Peugh18/Memora/README.md

# Memora

Pastillero inteligente 7 × 4 (ESP32) + API Laravel + app Android (Expo). Proyecto universitario, Trujillo, Perú.

- `firmware/` pastillero ESP32 · `servidor/` API · `app/` app móvil · `despliegue/` AWS · `diseno/` pantallas aprobadas
- Empieza por [AGENTS.md](AGENTS.md) y [docs/ai/PROYECTO.md](docs/ai/PROYECTO.md).
