Peugh18/Memora/caja/memora-caja-corte.pdf

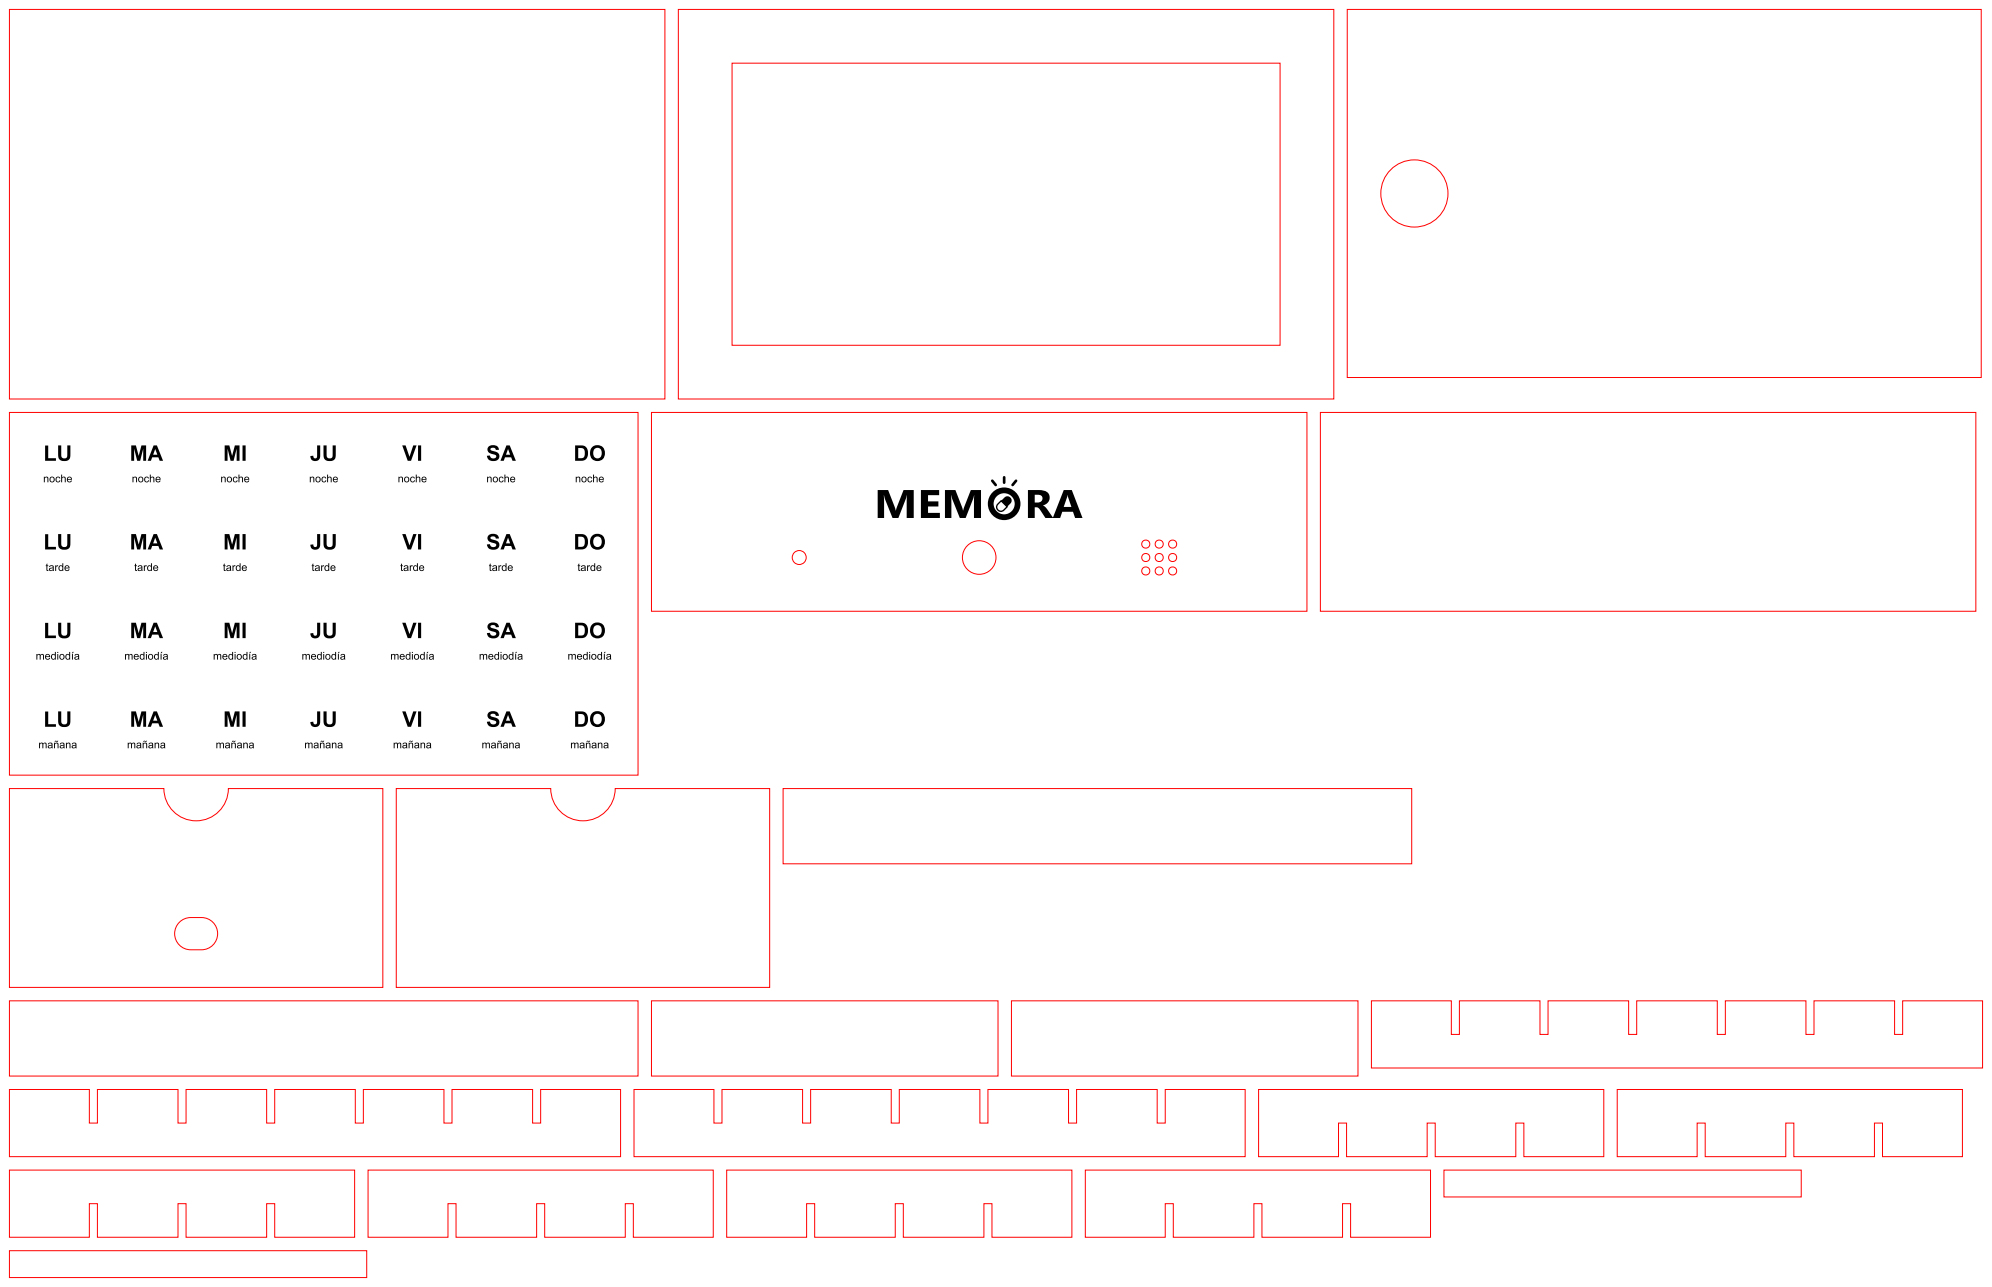
[picture p1: page 1]
