Peugh18/Memora/caja/memora-caja-guia.png

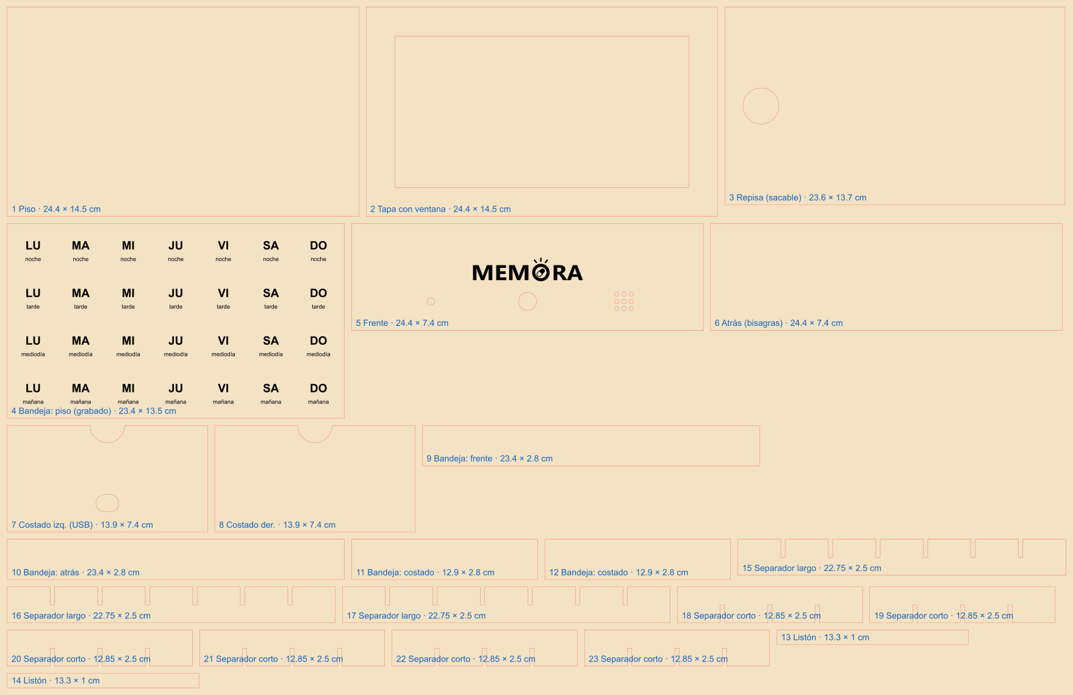
caja/memora-caja-guia.png
