Peugh18/Memora/caja/memora-caja-corte.dxf

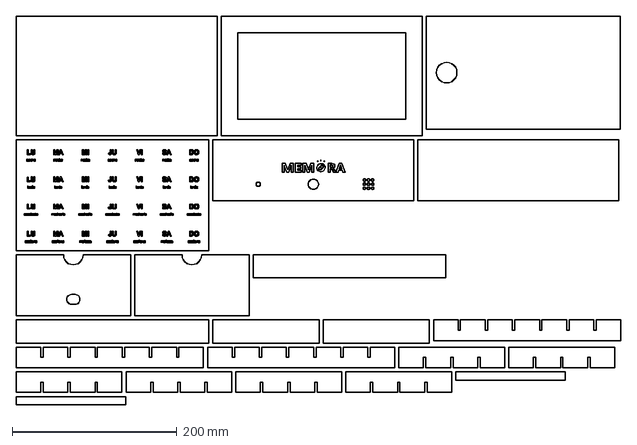
[picture p3: CAD file, 2026-10-25]
caja/memora-caja-corte.dxf
734.5 x 472.0 mm
