Peugh18/Memora/docs/manual/Manual-de-usuario-Memora.pdf

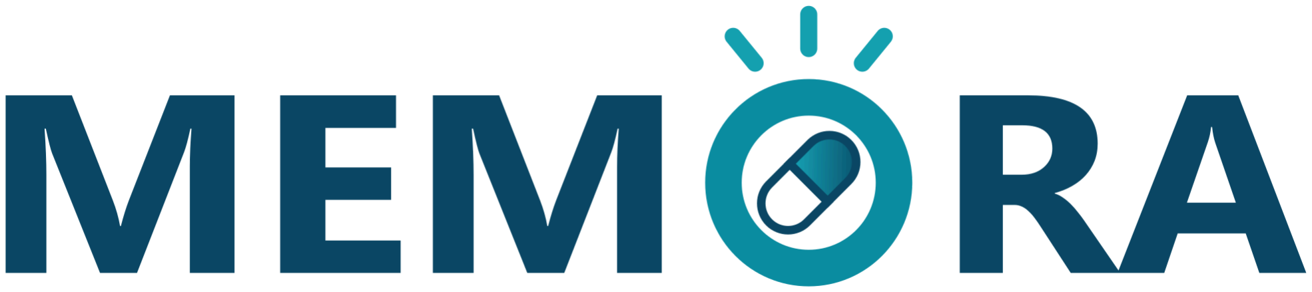
[picture p27: figure]

# Manual de usuario

### App Memora y pastillero inteligente

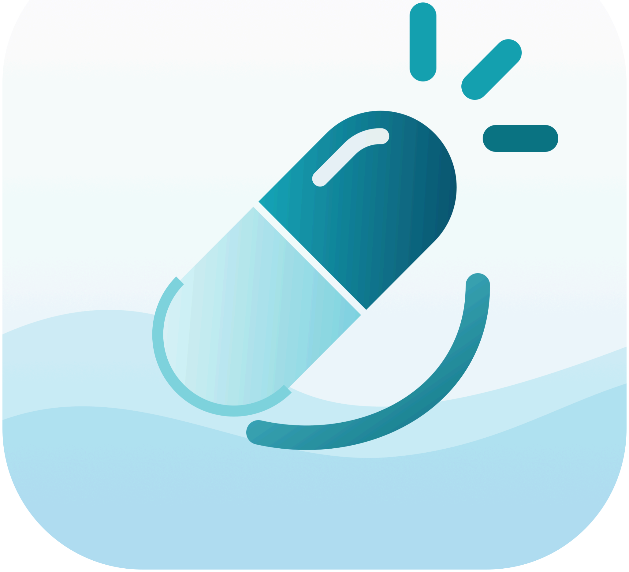
[picture p28: figure]

Versión 1.1 · octubre de 2026

## Contenido

1. Qué es Memora
2. Instalar la app
3. Conoce tu pastillero
4. Crear tu cuenta
5. Conectar el pastillero
6. Tu día: la pantalla Hoy
7. Pastillero y horarios
8. Medicamentos
9. Historial
10. Mi familia
11. Perfil y ajustes
12. Si cuidas a alguien
13. Volver a entrar
14. Si algo no funciona

## 1 Qué es Memora

Memora tiene dos partes que trabajan juntas:
El pastillero: una caja de 7 días por 4 tomas (mañana, mediodía, tarde y noche). A la hora de cada toma suena y prende su luz verde. Cuando tomas la pastilla, presionas su botón.
La app Memora en tu celular: ahí armas tu rutina, ves qué toca hoy y confirmas tus tomas. Tu familia también puede instalarla para acompañarte.
Si pasan 30 minutos y la toma no se confirma, Memora les avisa a las personas que te cuidan.

Lo que necesitas
Un celular Android con internet.
El pastillero enchufado a un cargador de celular (5 V).
Una red Wi-Fi de 2,4 GHz para el pastillero. Las redes de 5 GHz no funcionan. El código QR que viene pegado dentro de la tapa del pastillero.

## 2 Instalar la app

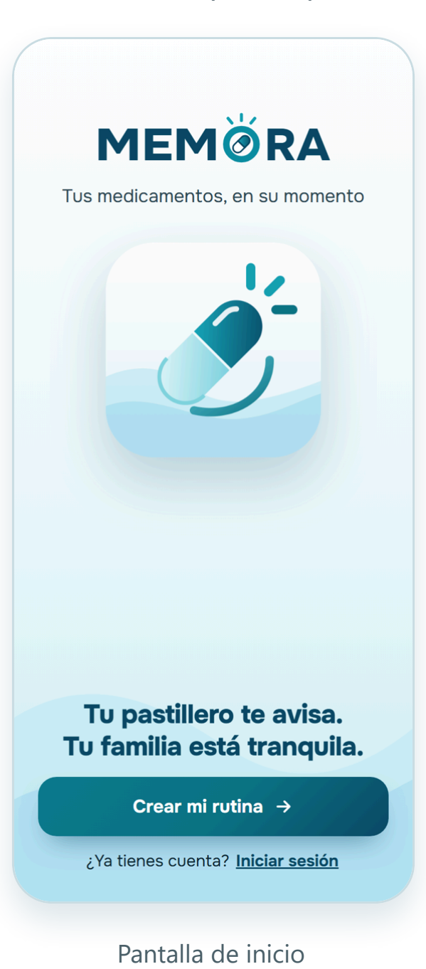
[picture p29: figure]
Pantalla de inicio

1. Abre en tu celular el enlace de descarga del archivo Memora.apk.
2. Toca Descargar y, al terminar, abre el archivo.

3. Si Android pide permiso para instalar apps de fuentes desconocidas, actívalo solo para tu navegador o tu gestor de archivos.
4. Toca Instalar. El ícono de Memora aparece en tu pantalla de inicio.

La primera vez que abras Memora, el celular te preguntará si permites notificaciones. Toca Permitir: así te llega el recordatorio a la hora de cada toma y, si cuidas a alguien, el aviso cuando no confirma.

## 3 Conoce tu pastillero

Lo que ves u oyes | Qué significa
Luz verde fija | Está conectado a internet y a Memora.
Luz verde apagada | Está sin internet. Igual suena a sus horas.
Bip-bip y luz que parpadea | Es hora de una toma.
Botón | Presiónalo cuando suene: apaga la alarma y avisa en la app que ya tomaste.
Botón presionado 10 segundos (sin alarma) | Borra el Wi-Fi guardado, para conectarlo a otra red.

Las 4 filas de colores son las 4 tomas del día: mañana (amarilla), mediodía (celeste), tarde (lila) y noche (rosa). Cada columna es un día, de lunes a domingo.
El pastillero guarda tu horario y la hora, así que suena aunque se vaya el internet.

## 4 Crear tu cuenta

1. En la pantalla de inicio toca Crear mi rutina.
2. Escribe tus nombres, tus apellidos y cómo quieres que te llamemos. Ese nombre corto es el que verás en el saludo.
3. Escribe tu celular. Marca Este número tiene WhatsApp si lo usas, para que tu familia pueda escribirte con un toque.
4. Elige cómo usarás Memora: Tomo medicamentos, Cuido a alguien o Las dos cosas.

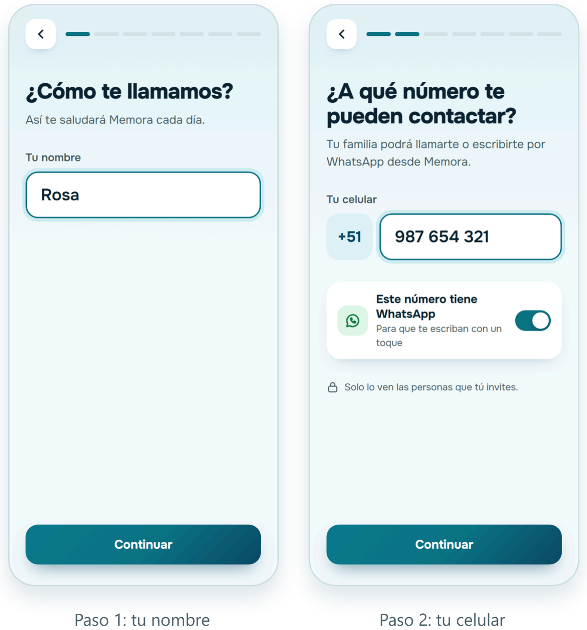
[picture p30: figure]
Paso 1: tu nombre; Paso 2: tu celular

1. Pon la hora de cada toma. Son las 4 filas de colores de tu pastillero; puedes cambiarlas después.
2. Agrega tu primer medicamento: nombre, dosis y en qué momentos del día lo tomas. Si prefieres, toca Lo agrego después.
3. Escribe tu correo y una contraseña de al menos 8 caracteres, y toca Crear cuenta.

Si solo cuidas a alguien, la app no te pide horarios ni medicamentos. Después de crear la cuenta te pide el código de invitación (sección 12).

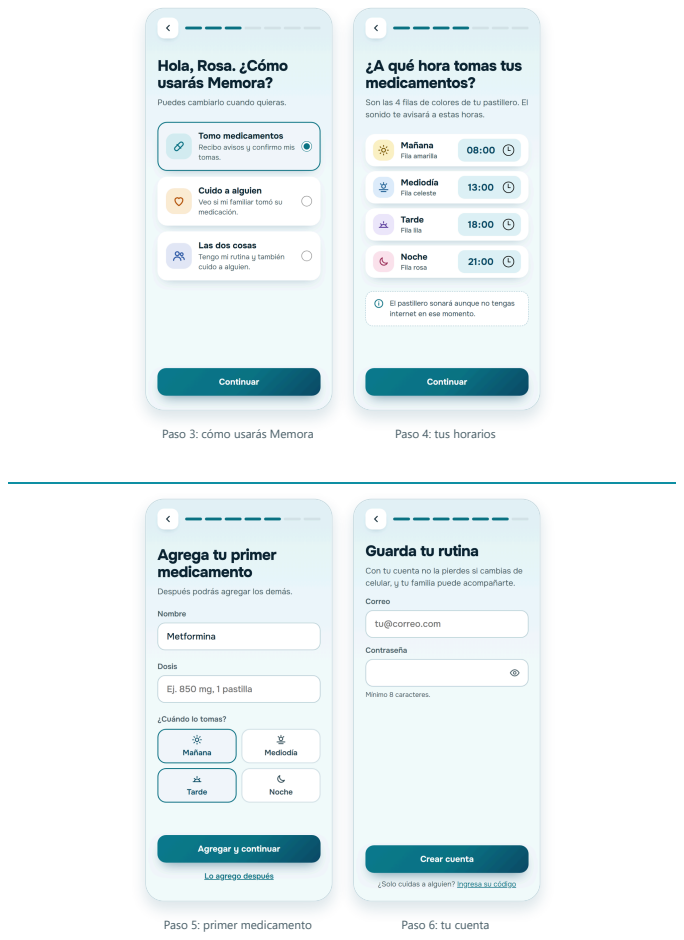
[picture p31: page 6]
Paso 3: cómo usarás Memora; Paso 4: tus horarios; Paso 5: primer medicamento; Paso 6: tu cuenta

## 5 Conectar el pastillero

Vincúlalo a tu cuenta
1. En la pantalla Conecta tu pastillero, apunta la cámara al QR pegado dentro de la tapa.
2. Si la cámara no lo lee, toca Escribir el código a mano y copia el código que está debajo del QR, por ejemplo MEM-0001-XXXXXX.
Dale tu Wi-Fi (solo la primera vez)
1. Enchufa el pastillero. Si no conoce ninguna red, crea la suya: Memora-MEM-0001.
2. En los ajustes de Wi-Fi de tu celular, conéctate a Memora-MEM-0001. Se abre una página; si no, entra a 192.168.4.1 en el navegador.
3. Toca Configure WiFi, elige tu red de 2,4 GHz, escribe su clave y guarda.
4. Cuando la luz verde quede fija, ya está listo. Vuelve tu celular a tu Wi-Fi de siempre.

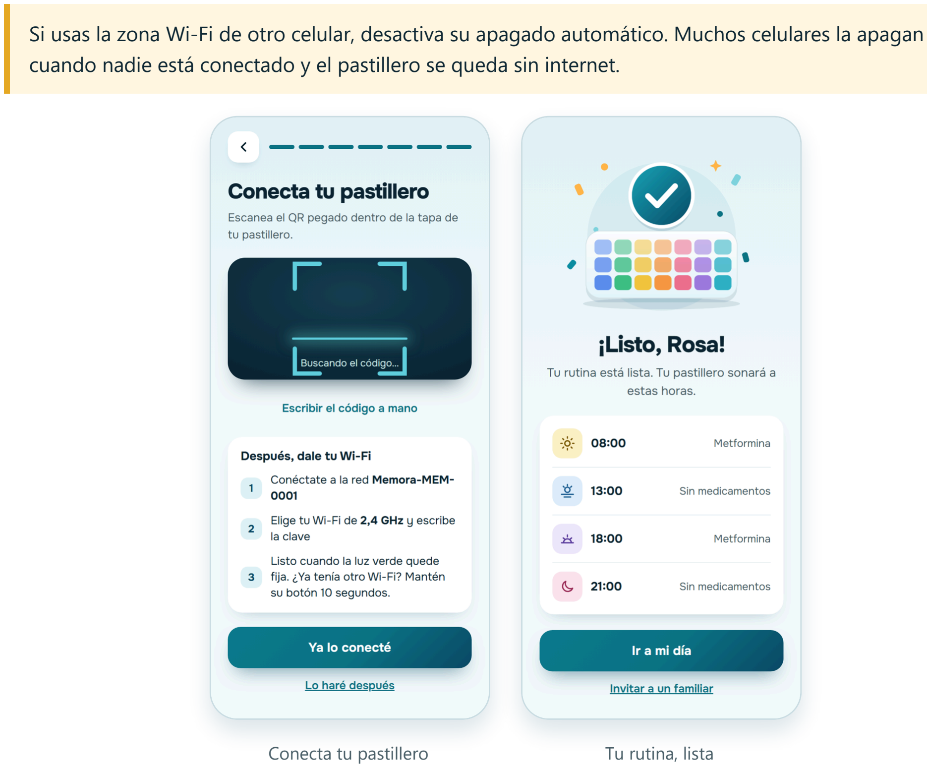
[picture p32: figure]
Conecta tu pastillero; Tu rutina, lista

Si usas la zona Wi-Fi de otro celular, desactiva su apagado automático. Muchos celulares la apagan cuando nadie está conectado y el pastillero se queda sin internet.

## 6 Tu día: la pantalla Hoy

Es la pantalla principal. Arriba ves la toma que toca y qué compartimento abrir. En la esquina, En línea indica que el pastillero está conectado.
Cuando el pastillero suena tienes tres opciones:
Presionar el botón del pastillero. Se calla y la app marca la toma como tomada en pocos segundos.
Ya la tomé, en la app: apaga el sonido y marca la toma.
Solo apagar el sonido: se calla, pero la toma sigue pendiente. Confírmala cuando la tomes. Si pasan 30 minutos, tu familia recibe un aviso.
A la misma hora te llega una notificación al celular, por ejemplo Hora de tus pastillas de la tarde. Llega aunque la app esté cerrada.
Si te equivocaste, toca Deshacer y la toma vuelve a quedar pendiente.
Abajo está la lista del día: Tomada con su hora, Ahora, Pendiente o Libre (sin medicamentos en ese momento).

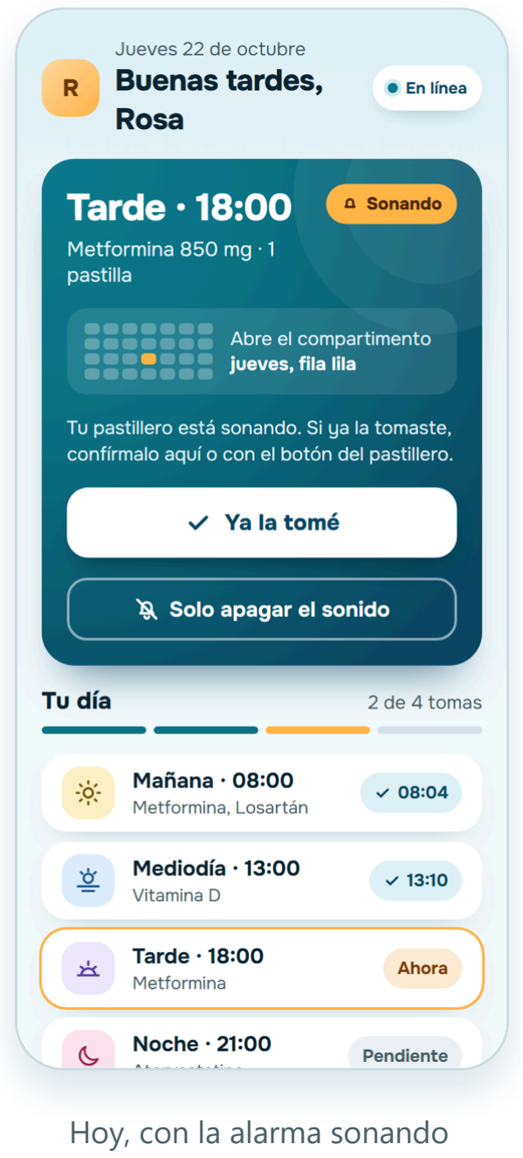
[picture p33: figure]
Hoy, con la alarma sonando

## 7 Pastillero y horarios

Toca la pestaña Pastillero.
La cuadrícula es igual a tu pastillero: el número dice cuántos medicamentos van en cada compartimento. La columna de hoy está resaltada.
Probar sonido hace sonar el pastillero; vuelve a tocar el botón, que ahora dice Apagar, para callarlo.
Para cambiar una hora, toca − o + (en pasos de 15 minutos) y luego Guardar horarios. El pastillero recibe la hora nueva en segundos.

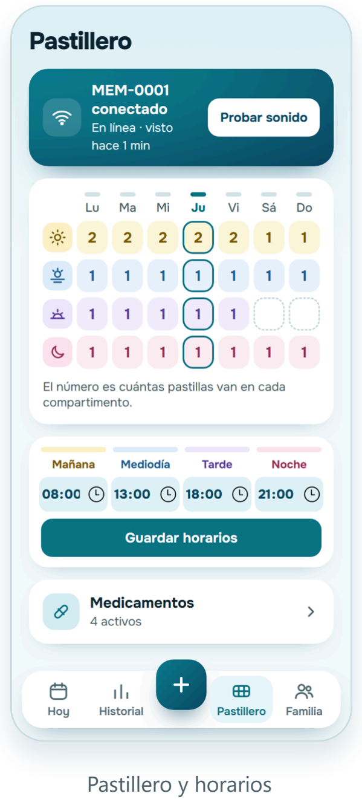
[picture p34: figure]
Pastillero y horarios

## 8 Medicamentos

1. Desde Pastillero toca Medicamentos, o toca el botón + de la barra de abajo.
2. Para uno nuevo: escribe nombre y dosis, elige los momentos del día y los días de la semana, y toca Guardar medicamento.
3. Para cambiar uno, tócalo en la lista. Para quitarlo, entra y toca Quitar medicamento.
Cada cambio actualiza solo el horario del pastillero: solo suena en los momentos que tienen medicamento.

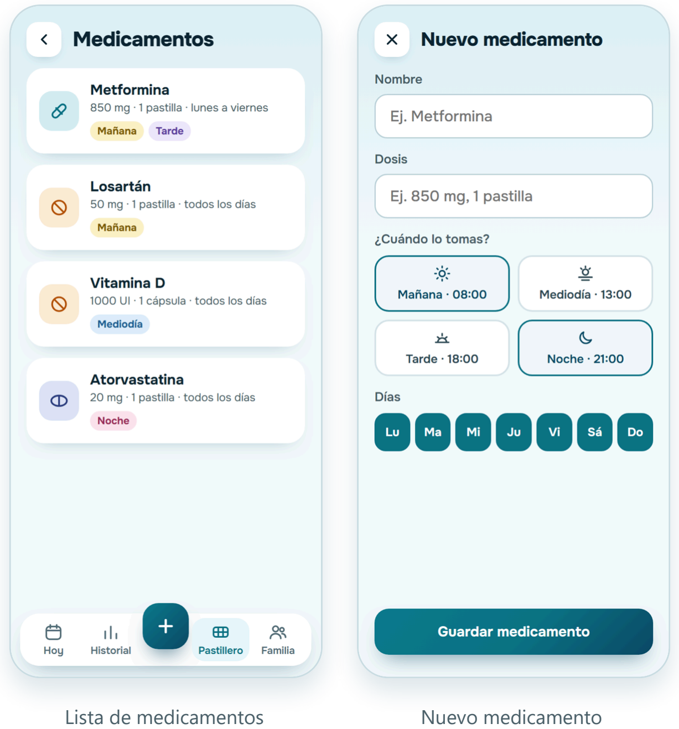
[picture p35: figure]
Lista de medicamentos; Nuevo medicamento

## 9 Historial

La pestaña Historial muestra tu semana: cada barra es un día, en turquesa las tomas confirmadas y en naranja las que no se confirmaron.
Debajo ves el porcentaje de tomas confirmadas de las últimas 4 semanas y la lista de tomas sin confirmar de esta semana.

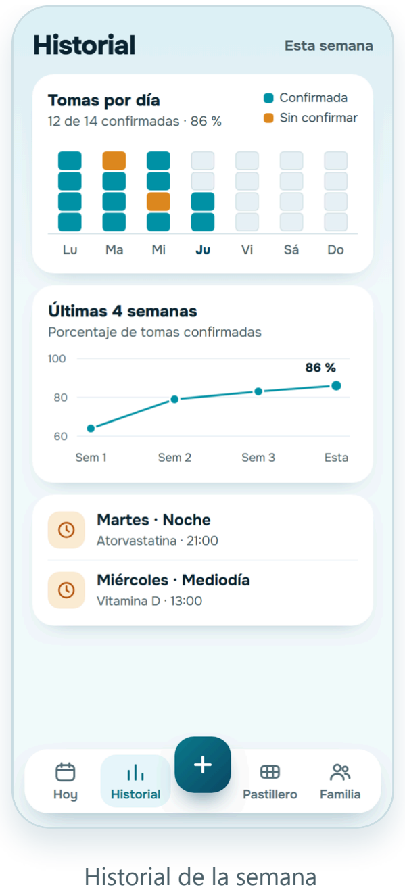
[picture p36: figure]
Historial de la semana

## 10 Mi familia

1. Toca la pestaña Familia.
2. En Invita a un familiar aparece tu código (vence en 24 horas). Cópialo o toca Compartir por WhatsApp.
3. Tu familiar lo escribe en su app (sección 12) y aparece en tu lista.
Junto a cada familiar tienes botones para llamarlo o escribirle por WhatsApp. El interruptor Puede editar mis horarios le da permiso para cambiar tus horas y medicamentos. Las tomas solo las confirmas tú.

## 11 Perfil y ajustes

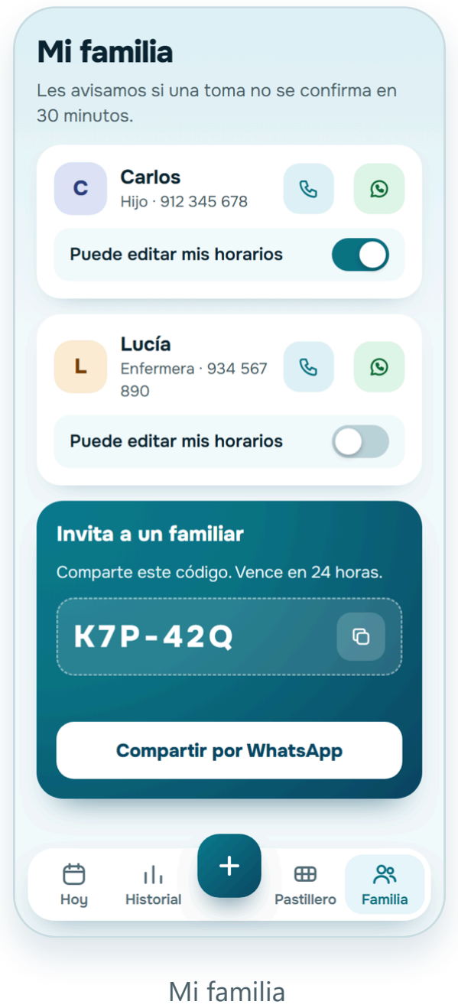
[picture p37: figure]
Mi familia

Toca tu inicial, arriba a la izquierda en Hoy.
Datos personales: nombre, cómo te llamamos, celular, correo y contraseña.
Avisar a mi familia tras: tócalo para elegir 15, 30, 45 o 60 minutos.
Avisos en el celular: el recordatorio a la hora de cada toma y, si cuidas a alguien, el aviso cuando no confirma. Avisos por WhatsApp: actívalo si prefieres ese medio.
Cambiar el Wi-Fi del pastillero: repite los pasos de la sección 5.

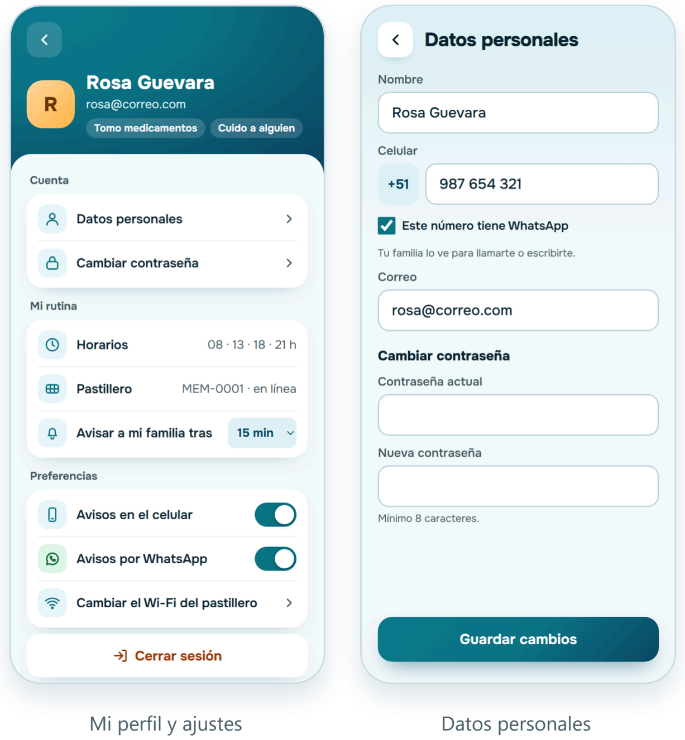
[picture p38: figure]
Mi perfil y ajustes; Datos personales

Cerrar sesión, al final de la pantalla.

## 12 Si cuidas a alguien

1. Crea tu cuenta eligiendo Cuido a alguien.
2. Escribe el código de invitación que te pasó tu familiar, elige qué es de ti (mamá, papá, etc.) y toca Unirme.
3. En Personas que cuido ves a cada persona con sus tomas de hoy. Si alguien no confirmó a tiempo, aparece un aviso naranja arriba.
4. Toca a la persona para ver su semana, llamarla o escribirle por WhatsApp. Si te dio permiso, verás

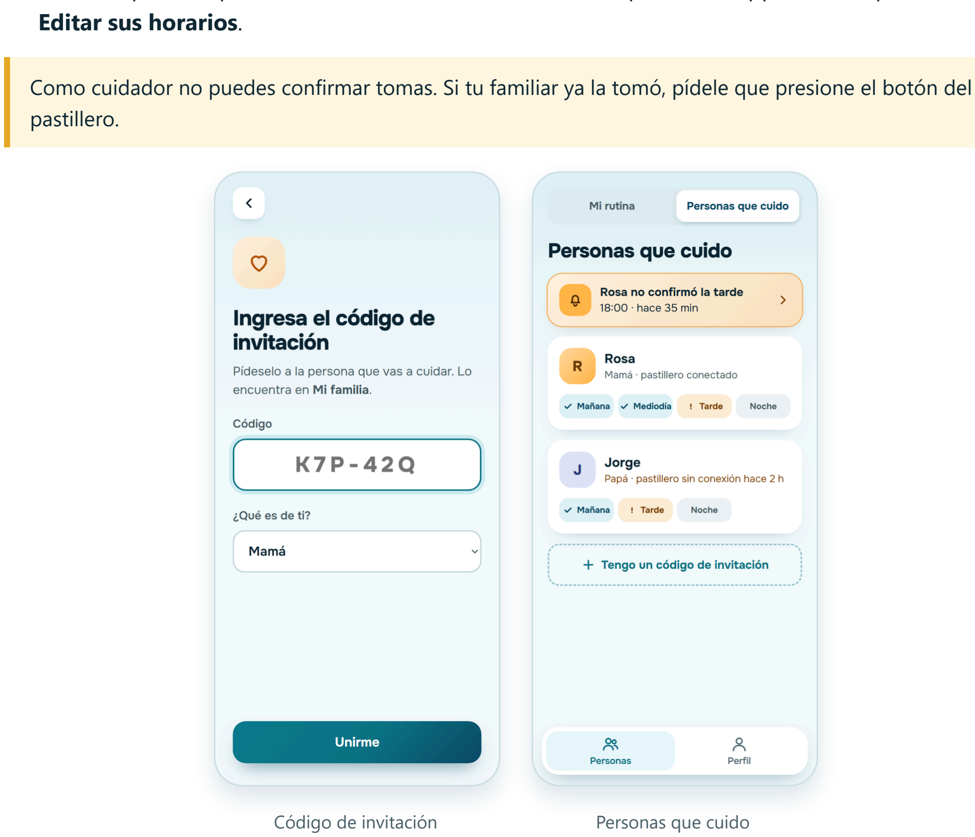
[picture p39: figure]
Editar sus horarios.; pastillero.; Código de invitación; Personas que cuido

Como cuidador no puedes confirmar tomas. Si tu familiar ya la tomó, pídele que presione el botón del

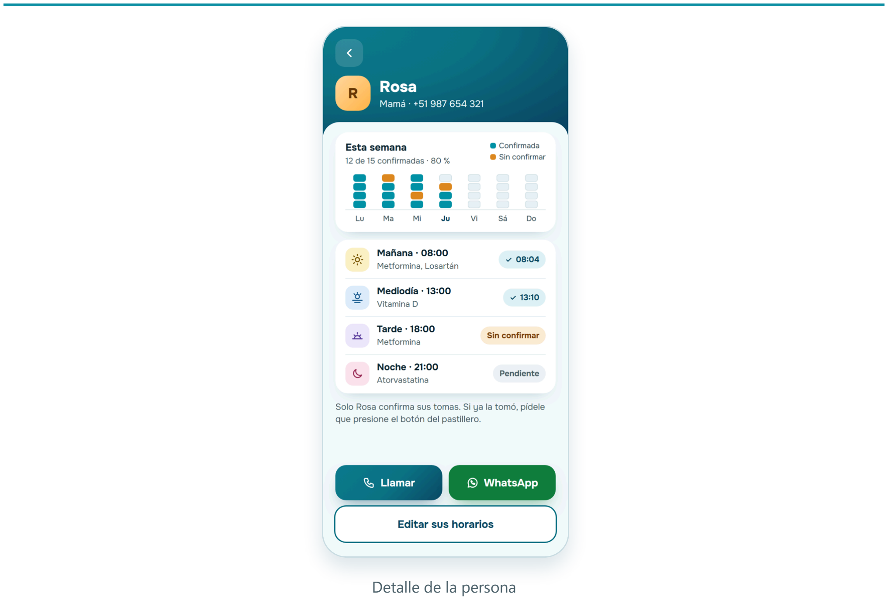
[picture p40: figure]
Detalle de la persona

## 13 Volver a entrar

Si cambias de celular o cerraste sesión, toca Iniciar sesión en la pantalla de inicio y escribe tu correo y contraseña. Tu rutina sigue guardada.
Si no recuerdas la contraseña:
1. Toca Olvidé mi contraseña, escribe tu correo y toca Enviar código.
2. Revisa tu correo (también la carpeta de spam). Te llega un mensaje de Memora con un código de 6 números.
3. Escribe ese código y tu contraseña nueva (mínimo 8 caracteres) y toca Guardar y entrar.

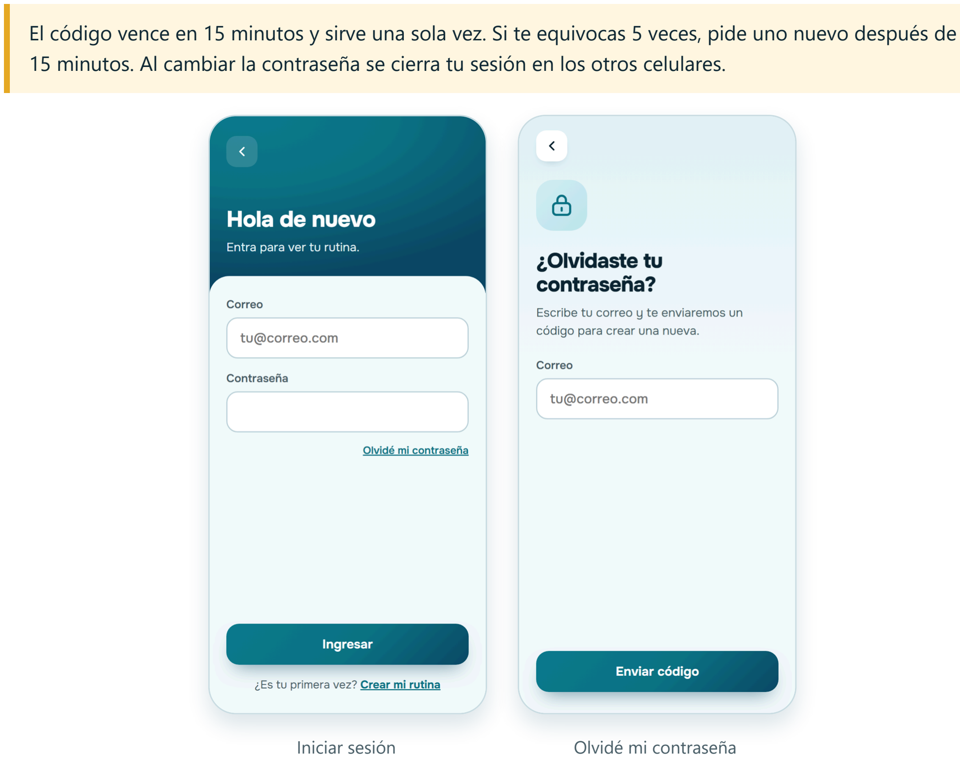
[picture p41: figure]
Iniciar sesión; Olvidé mi contraseña

El código vence en 15 minutos y sirve una sola vez. Si te equivocas 5 veces, pide uno nuevo después de 15 minutos. Al cambiar la contraseña se cierra tu sesión en los otros celulares.

## 14 Si algo no funciona

Problema | Qué hacer
La app dice Sin conexión o la luz verde no queda fija | Revisa que el Wi-Fi del pastillero esté prendido y sea de 2,4 GHz. Si cambiaste de red, mantén su botón 10 segundos y repite la sección 5.
No aparece la red Memora-MEM-0001 | Desenchufa el pastillero y vuelve a enchufarlo. La red aparece cerca de un minuto después y dura 3 minutos.
No sonó a la hora | Ese momento del día debe tener un medicamento para ese día. Revisa la cuadrícula en Pastillero.
La app no muestra la toma como tomada | Espera unos segundos: la app se actualiza sola cada 5 segundos. Si no hay internet, confírmala con Ya la tomé.
No me llegan las notificaciones | Revisa que Memora tenga permiso de notificaciones en los ajustes del celular y que Avisos en el celular esté activado en tu perfil. Luego cierra sesión y vuelve a entrar. Si tu celular ahorra batería, quita a Memora de esa lista.
Mi familiar no recibe avisos | Debe tener la app instalada, haber aceptado las notificaciones y tener activado Avisos en el celular en su perfil.
No me llega el código para cambiar la contraseña | Espera un minuto y revisa spam. Comprueba que escribiste el mismo correo de tu cuenta. Si pediste varios, usa solo el último.
El QR no se lee | Toca Escribir el código a mano y copia el código escrito debajo del QR.
