Peugh18/Memora/caja/memora-caja-planos.pdf

# Caja Memora: planos con medidas

Todas las medidas en centímetros. Rojo = corte, negro = grabado. Caja armada: 24,4 × 14,5 × 8 cm. Acrílico

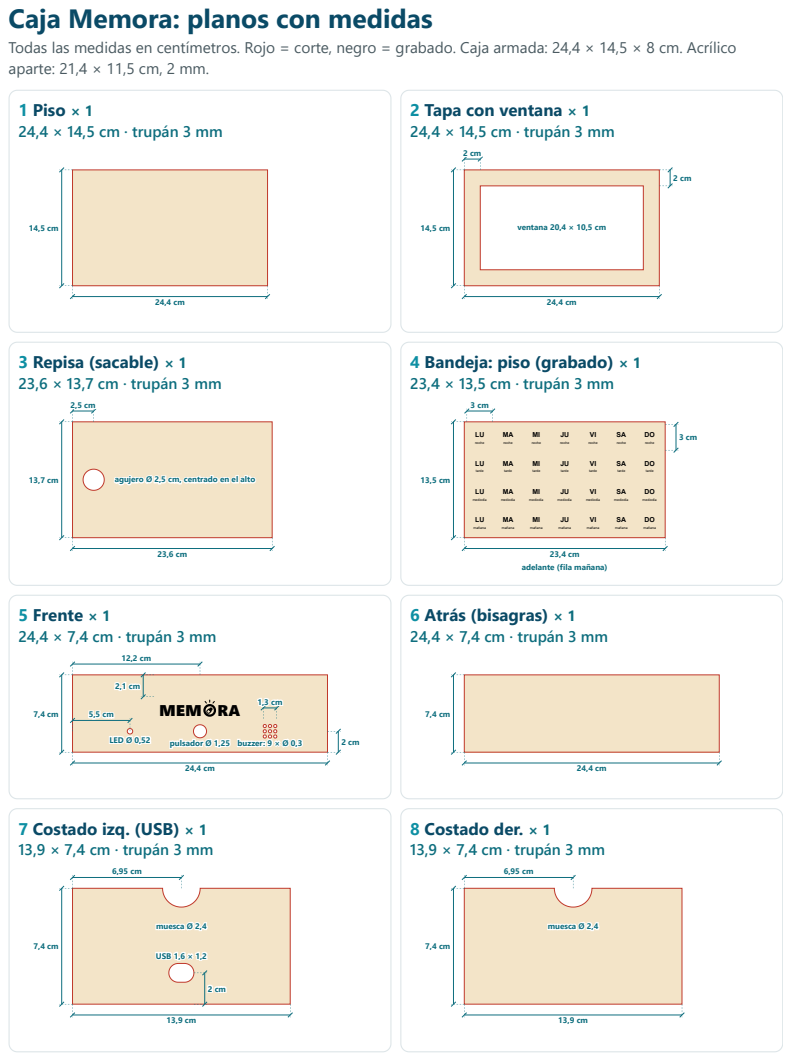
[picture p42: page 1]
24,4 cm; 14,5 cm; ventana 20,4 × 10,5 cm; 23,6 cm; 13,7 cm; 2,5 cm; mañana; mediodía; tarde; noche; 13,5 cm; MEM RA; 7,4 cm; 5,5 cm; 12,2 cm; 1,3 cm; 2,1 cm; LED Ø 0,,52; pulsador Ø 1,25 buzzer: 9 × Ø 0,,3; 13,9 cm; 6,95 cm; muesca Ø 2,,4; USB 1,6 × 1,2

aparte: 21,4 × 11,5 cm, 2 mm.
1 Piso × 1
24,4 × 14,5 cm · trupán 3 mm

2 Tapa con ventana × 1

3 Repisa (sacable) × 1
23,6 × 13,7 cm · trupán 3 mm

4 Bandeja: piso (grabado) × 1
23,4 × 13,5 cm · trupán 3 mm

agujero Ø 2,5 cm, centrado en el alto

2233,,44 ccmm
adelante (fila mañana)

5 Frente × 1
24,4 × 7,4 cm · trupán 3 mm

6 Atrás (bisagras) × 1

7 Costado izq. (USB) × 1
13,9 × 7,4 cm · trupán 3 mm

8 Costado der. × 1

# 9 Bandeja: frente × 1

# 23,4 × 2,8 cm · trupán 3 mm

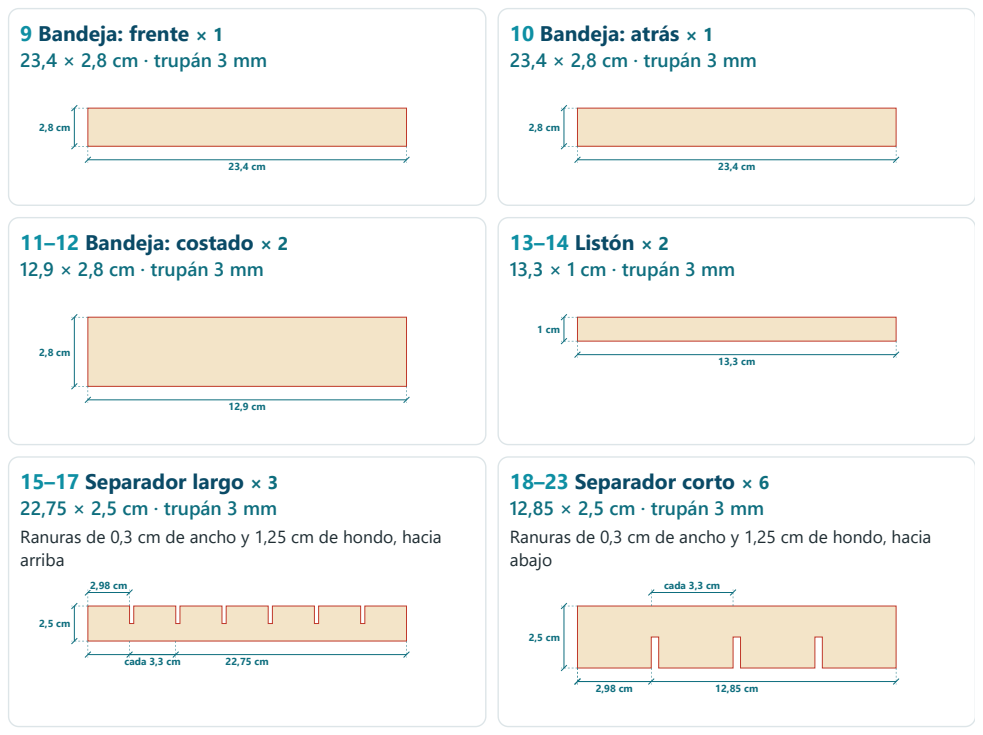
[picture p43: page 2]
23,4 cm; 2,8 cm; 12,9 cm; 13,3 cm; 22,75 cm; 2,5 cm; 2,98 cm; cada 3,3 cm; 12,85 cm

10 Bandeja: atrás × 1
23,4 × 2,8 cm · trupán 3 mm

11–12 Bandeja: costado × 2
12,9 × 2,8 cm · trupán 3 mm

13–14 Listón × 2
13,3 × 1 cm · trupán 3 mm

15–17 Separador largo × 3
22,75 × 2,5 cm · trupán 3 mm
Ranuras de 0,3 cm de ancho y 1,25 cm de hondo, hacia
arriba

18–23 Separador corto × 6
12,85 × 2,5 cm · trupán 3 mm
abajo
