Peugh18/Memora/assets/ilustraciones/bienvenida.pdf

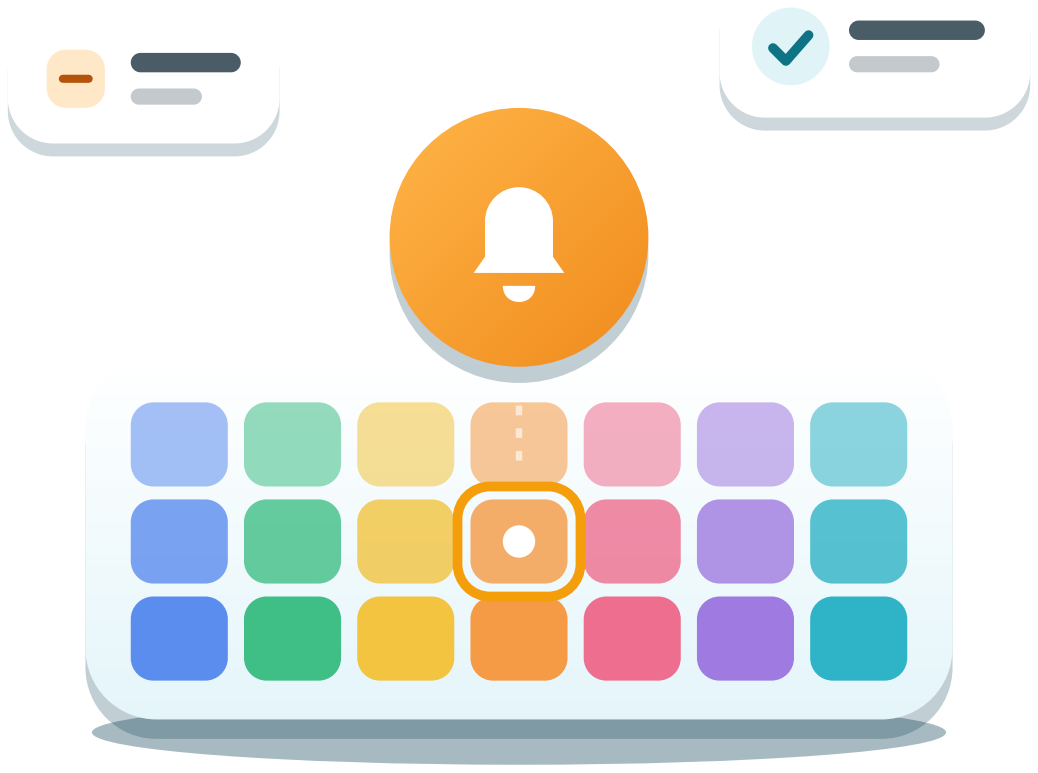
[picture p44: page 1]
