Peugh18/Memora/assets/ilustraciones/listo.pdf

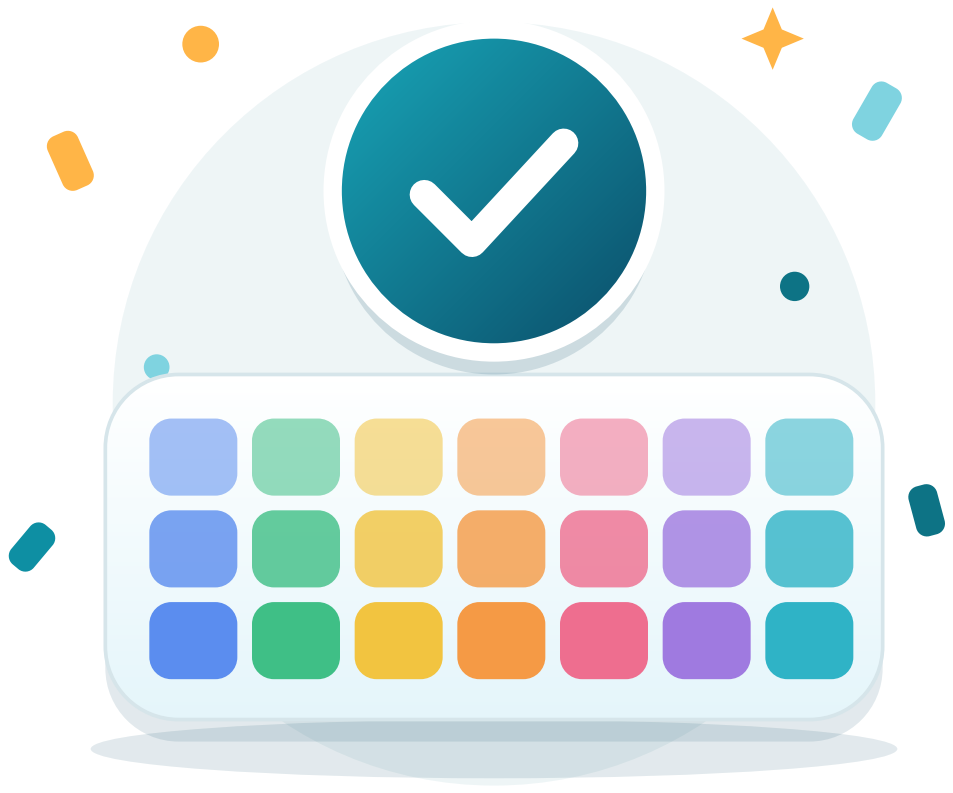
[picture p45: page 1]
