Peugh18/Memora/(commit log)

2026-10-25 Memora: firmware, API Laravel, app Expo, diseño y despliegue en AWS
    Pastillero ESP32 7x4 con alarma, botón y reloj; API con tomas, cuidadores y
    MQTT; app Android de 22 pantallas; Docker con FrankenPHP y Mosquitto con TLS.
    Los secretos (clave del QR, .env, base de datos) quedan fuera del repositorio.
2026-10-25 Seguridad: límite de intentos al vincular, invitar y cambiar clave
    Cinco intentos por minuto para que la clave del QR y el código de invitación
    no se adivinen probando; contraseñas con máximo de 72 caracteres (bcrypt).
2026-10-25 Instalador: apaga nginx o apache que ocupen el puerto 80
2026-10-25 App: actualiza cada 5 s y al volver a la app; refresca tras guardar horarios
2026-10-25 Docs: prueba completa contra AWS y pendientes de hardware
2026-10-25 Buzzer y LED a 5 V con transistores NPN: firmware y guía de armado
2026-10-25 Despliegue: cómo apagar y prender la EC2 para ahorrar
2026-10-25 Guía: buzzer y LED a 5 V usando los rieles
2026-10-28 Olvidé mi contraseña con código por correo (Gmail SMTP) y manual de usuario
    - La API daba 500 al pedir el enlace (ruta password.reset inexistente) y el correo estaba en modo log.
    - Código de 6 dígitos: vence en 15 min, un solo uso, 5 fallos por correo lo borran.
    - instalar.sh pide el Gmail y su contraseña de aplicación, y recrea el passwd de Mosquitto.
    - Manual de usuario en PDF con las pantallas del diseño.
2026-10-28 Restablecer clave: contar el intento antes de revisar el código
    Máximo 5 intentos por correo cada 15 min aunque se pidan códigos nuevos o lleguen en paralelo.
2026-10-29 Aviso al paciente a la hora de cada toma
    Antes solo se avisaba al cuidador cuando una toma quedaba omitida. La app vuelve a registrar el token de avisos al abrirse.
2026-10-29 Manual 1.1: recordatorios en el celular y recuperar contraseña con código
